angelatlarge/RGBOV/TLC5940/RGBOV.sch

## KiCad design TLC5940/RGBOV.sch (2013-05-15)

Schematic: RGBOV.sch

Parts:
C1, C2: 22pF
C3, C4: C
IC1: ATMEGA328-P; DIL28
IC2: TLC5940
R1: 2K2
X1: CRYSTAL

Notes on the sheet:
PROG indicator
Hall switch on indicator
green
white
black
yellow
red
IREFpin must be connected to GND through an IREF resistor The max channel I of TLC5940 = V-IREF/R-IREF * 31.5. V-IREF is usually 1.24V, so R-IREF=2k2 yields 17mA channel I
Parallel SIN
to BTH
Hall effect switch
