angelatlarge/RGBOV/shared/graphic.c

#ifndef GRAPHIC_C
#define GRAPHIC_C
#include <avr/pgmspace.h>

// Define useful padding for the graphics
#define PAD_001	0x00
#define PAD_002	PAD_001, PAD_001
#define PAD_003	PAD_001, PAD_001, PAD_001
#define PAD_005	PAD_003, PAD_002
#define PAD_010	PAD_005, PAD_005
#define PAD_020	PAD_010, PAD_010
#define PAD_030	PAD_020, PAD_010
#define PAD_040	PAD_020, PAD_020
#define PAD_050	PAD_040, PAD_010
#define PAD_100	PAD_050, PAD_050

/* 	Rules of graphics
	Horizontal dimension first, vertical dimension second
	First palette color MUST be black
	Palette order is (RGB)
*/	


#define TEST_GRAPHIC_F

#if defined TEST_GRAPHIC_A

// Test graphic A
#define GRAPHIC_WIDTH	100
#define GRAPHIC_HEIGHT	30
#define PALETTE_SIZE	5
//~ uint8_t palette[PALETTE_SIZE * 3] = {0x07, 0x07, 0x07, 0x00, 0x00, 0x00};
uint8_t palette[PALETTE_SIZE * 3] = {
	0x00, 0x00, 0x00, 
	0x07, 0x00, 0x00,
	0x00, 0x07, 0x00, 
	0x00, 0x00, 0x07,
	0x07, 0x00, 0x07,
};
	//~ 0x07, 0x00, 0x00
	//~ 0x00, 0x07, 0x00, 
	//~ 0x00, 0x00, 0x07};
#ifdef PROGMEM_GRAPHIC
const uint8_t graphic[GRAPHIC_WIDTH][GRAPHIC_HEIGHT] PROGMEM = 
#else // PROGMEM_GRAPHIC
uint8_t graphic[GRAPHIC_WIDTH][GRAPHIC_HEIGHT] = 
#endif 
{
//~  1,    2,    3,    4,    5,    6,    7,    8,    9,   10,   11,   12,   13,   14,   15,   16,   17,   18,   19,   20,   21,   22,   23,   24,   25,   26,   27,   28,   29,   30
	
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
{0x00,0x00,0x00,0x00,0x00,0x00,0x00,0x00,0x00,0x00,0x00,0x00,0x00,0x03,0x00},
{0x00,0x00,0x00,0x00,0x00,0x00,0x00,0x00,0x00,0x00,0x00,0x00,0x00,0x00,0x03},


};


#endif /* Which test graphic is defined */

#endif /* GRAPHIC_C */
