angelatlarge/RGBOV/TLC5940/load.cpp

#include <string.h>
#include "../shared/load.h"
#include "../shared/settings.h"
#include "strfmt.h"
#include "util/delay.h"



#if INTENSITY_LEVELS>1			
#error For TLC5940 INTENSITY_LEVELS must be set at zero
#endif


#define nop()  __asm__ __volatile__("nop")

#include "../shared/graphic.c"

#if GRAPHIC_HEIGHT>VERTICAL_PIXELS
#	define COLUMN_DATA_BYTES	(GRAPHIC_HEIGHT*3)
#else
#	define COLUMN_DATA_BYTES	(VERTICAL_PIXELS*3)
#endif

#define STR_HELPER(x) #x
#define STR(x) STR_HELPER(x)

#pragma message "#################################"
#pragma message "###   Horizontal pixels " STR(HORZ_PIXELS)      "   ###"
#pragma message "###   Vertical pixels    " STR(VERTICAL_PIXELS) "   ###"
#pragma message "###   Graphic height     " STR(GRAPHIC_HEIGHT)  "   ###"
#pragma message "###   Graphic width     " STR(GRAPHIC_WIDTH)  "   ###"
#pragma message "###   Sides               " STR(SIDES_COUNT)  "   ###"
#pragma message "###   Spokes              " STR(SPOKES_COUNT)  "   ###"
#pragma message "#################################"


#define PRECOMPUTE_PALETTE		/* 	Optimization that does palette exponentiation at initialization.  
									Can saves about 51.2us of the loading time
									*/

#define LEDS_PER_CHIP		5
#define CHIPS_PER_UNIT		3
#define LINES_PER_CHIP		(LEDS_PER_CHIP*3)

/*
	Unit = circuit (LED drivers) for one spoke, one side.
*/



	
#define TLC5940_XLAT_BIT	7
#define TLC5940_XLAT_PORT	PORTD
#define TLC5940_XLAT_DDR	DDRD
#define TLC5940_XLAT_PINS	PIND

#define TLC5940_DCPRG_BIT	4
#define TLC5940_DCPRG_PORT	PORTB
#define TLC5940_DCPRG_DDR	DDRB
#define TLC5940_DCPRG_PINS	PINB

#define TLC5940_VPRG_BIT	5
#define TLC5940_VPRG_PORT	PORTB
#define TLC5940_VPRG_DDR	DDRB
#define TLC5940_VPRG_PINS	PINB

#define DRIVER_SWITCH_PORT	PORTC
#define DRIVER_SWITCH_BIT	5
#define DRIVER_SWITCH_DDR	DDRC
#define DRIVER_SWITCH_PINS	PINC

#define PROGMEM_GRAPHIC
	
//~ static uint8_t nColumnData[SIDES_COUNT*SPOKES_COUNT][COLUMN_DATA_BYTES];
static uint8_t useHeight = (VERTICAL_PIXELS<GRAPHIC_HEIGHT) ? VERTICAL_PIXELS : GRAPHIC_HEIGHT;
#define VOLREG

static uint8_t nUnitWidth = HORZ_PIXELS / SPOKES_COUNT;

void loadingPrepareUpdate(uint8_t idxHorizontalPixel) {
	
	TLC5940_XLAT_PORT &= ~(1<<TLC5940_XLAT_BIT);		// XLAT -> low

	uint8_t idxUnit = 0;
	
	do { // This is the unit loop
		
		// Set the bits to go to the right unit
		switch (idxUnit) {
		case 1:
			//~ dputs("Port off");
			DRIVER_SWITCH_PORT &= ~(1<<DRIVER_SWITCH_BIT);
			break;
		case 0:
			//~ dputs("Port on");
			DRIVER_SWITCH_PORT |= (1<<DRIVER_SWITCH_BIT);
			break;
		}
		
		/* 	Wait for the switch to settle down
			We may not need it depending on how long the subsequent operations take
			in the worst case the current switch we are using.
			
			Some faster switches:
				SN74LVC1G3157 
				TS5A3157
				TS12A12511 - wide voltage range, up to 100ns propagation time
		*/
		nop();
		nop();
		nop();
		nop();
		nop();
		nop();
		nop();
		nop();
		nop();
		nop();
		nop();
		nop();
		nop();
		nop();
		nop();
		nop();
		nop();
		nop();
		nop();
		nop();
		nop();
		nop();
		nop();
		nop();
		nop();
		nop();
		nop();
		nop();
		
			
		// Use this for a single spoke
		//~ uint8_t nUnitColumnIndex = idxHorizontalPixel;
		// Use this for more than one spoke
		uint8_t nUnitColumnIndex = (idxHorizontalPixel + nUnitWidth*idxUnit) % HORZ_PIXELS;
		
		if (
					( nUnitColumnIndex<GRAPHIC_WIDTH ) 
				&& 
					(idxHorizontalPixel<HORZ_PIXELS) 		// Overflow generates black:
															// if the caller tells us to draw a non-existent pixel
															// we draw black
			) 
		{
			// Write graphics data to the drivers

			/* 	Padding: we need to pre-pad
				We will send 15 12-bit values (180 bits) which is 22.5 8-bit SPI 8-bit bytes
				For every TLC5490 we actually need to send 16 12-bit values (192 bits in total)
				because that's what the TLC5490 serial comms expect. 
				Since we are using only 15 of the output lines, 
				the 16th value is unnecessary (we are not using OUT15)
				We also need to pad for the extra nibble (22.5 SPI above) 
				So if we start by sending the empty 12-bit value, we are OK
				This padding needs to be done for every chip
			*/
			SPDR = 0;					// First 8 bits of the empty 12-bit data
			while(!(SPSR & (1<<SPIF))) {
				// Wait for the transfer to finish
			}
			SPDR = 0;					// Last 4 bits of the empty 12-bit data
										// plus the empty 4 high bits of the first intensity data
			uint8_t nBytesSent = 2;	// Initialize to two to account for 
										// the two blanking bytes we just sent
			VOLREG uint8_t idxNextSendType = 2;	// The next send type is type 2
												// so we indicate that
			
			// Different curColDatas are not implemented yet
			//~ uint8_t * curColData = nColumnData[idxUnit];
			
			const uint8_t * ptrGraphicFirst = &(graphic[nUnitColumnIndex][0]);
			const uint8_t * ptrGraphicLastPlusOne = ptrGraphicFirst + GRAPHIC_HEIGHT;
			const uint8_t * ptrGraphic = ptrGraphicFirst + VERTICAL_PIXELS; // Note: we'll use PRE-decrement everywhere
			
			VOLREG uint8_t idxChannel = 2;	// We want to walk the channels in reverse
			VOLREG uint8_t nPaletteIndex = 0;
			if (--ptrGraphic<ptrGraphicLastPlusOne) {
				nPaletteIndex = pgm_read_byte(ptrGraphic);
			} 
			//~ uint8_t * ptrDataSrc = palette + nPaletteIndex*3+idxChannel--;
			uint8_t * ptrDataSrc = &palette[nPaletteIndex*3+idxChannel--];
			VOLREG uint8_t dataByte = *ptrDataSrc;
			ptrDataSrc--;
			//~ VOLREG uint8_t dataByte = (idxChannel++>=1)?0xFF:0x00;
			
			VOLREG uint8_t toSPDR = dataByte;
			uint8_t nChipsSent = 0;
			
			for (;;) { // Send bytes loop
				while(!(SPSR & (1<<SPIF))) {
					// Wait for the previous transfer to finish
				}
				SPDR = toSPDR;			// Send the byte
				nBytesSent++;
				
				// Check for LED driver edge
				if (nBytesSent == 24) {
					// Send fake (zero-ed out) data for channel 16, which we do not use
					nBytesSent = 0;
					
					if (++nChipsSent == CHIPS_PER_UNIT) 
						break;
					
					while(!(SPSR & (1<<SPIF))) {
						// Wait for the previous transfer to finish
					}
					SPDR = 0;					// First 8 bits of the empty 12-bit data
					while(!(SPSR & (1<<SPIF))) {
						// Wait for the transfer to finish
					}
					SPDR = 0;					// Last 4 bits of the empty 12-bit data
												// plus the empty 4 high bits of the first intensity data
					idxNextSendType = 1;		// It will get incremented first
												// so the first byte will actually be
												// idxNextSendType = 2
					nBytesSent += 2;
					idxChannel = 2;
				}
				
				// Update the send type
				if (++idxNextSendType>2) { idxNextSendType = 0; }
				//~ ++idxNextSendType %= 4;
				
				// Prepare the next one for loading
				if (idxNextSendType==1) {
					// Case 1: Need to send the low nibble + padding
					toSPDR = dataByte<<4;
				} else {
					// Either way we need another new data in dataByte
					if (idxChannel==2) {
						// Load next palette index
						/* 	Used to have an out-of-bounds check here
							but it isn't necessary 
						if (--ptrGraphic < ptrGraphicFirst)
							break;
						*/
						if (--ptrGraphic<ptrGraphicLastPlusOne) {
							nPaletteIndex = pgm_read_byte(ptrGraphic);
							//~ ptrDataSrc = palette + nPaletteIndex*3+2;
							ptrDataSrc = &palette[nPaletteIndex*3+2];
						}
					}
					
					dataByte = *ptrDataSrc;
					ptrDataSrc--;
					//~ dataByte = (idxChannel>=1)?0xFF:0x00;
					if (idxChannel--==0) idxChannel = 2;
					//~ This fails: ++idxChannel %= 3;
					
					if (idxNextSendType) {
						// idxSendType == 2
						// Case 2: Need to send pure data
						toSPDR = dataByte;
					} else {
						// idxSendType == 0
						// Case 0: Need to send padding + high nibble
						toSPDR = dataByte >> 4;
					}
				}
				
			} // End of send bytes loop
			
		} else {
			// Send black
#ifdef BLANK_MANUALLY
			// Manual blanking by twiddling the clock bit
			SPCR &= ~(1<<SPE)		// Disable SPI
			PORTB &= ~(1<<3);			// Data line low
			for (uint16_t i=0;i<192*CHIPS_PER_UNIT;i++) {
				PORTB |= (1<<5);			// Clock high
				nop();
				PORTB &= ~(1<<5);		// Clock low
			}
#else		
			// Blank by sending zeroed out data
			for (uint8_t i=0;i<24*CHIPS_PER_UNIT;i++) {		// 24 is the number of 8-bit bytes to send
															// in order to send 16 12-bit values
				while(!(SPSR & (1<<SPIF))) {
					// Wait for the previous transfer to finish
				}
				SPDR = 0;			// Send the byte
			}		
#endif		
		}
		
	} while (++idxUnit < SIDES_COUNT*SPOKES_COUNT);	// 	End of the unit loop,
	

	
}

void loadingUpdateDisplay(uint8_t idxHorizontalPixel) {
	//~ PORTD |= 1<<3;
	//~ uint8_t tcc1bSave = TCCR1B;
	//~ TCCR2B &= ~((1<<CS22)|(1<<CS21)|(1<<CS20));
	//~ for (int i=0;i<10000;i++) nop();
	TLC5940_XLAT_PORT |= 1<<TLC5940_XLAT_BIT;			// XLAT -> high
	//~ TCNT2H = 0;
	//~ for (int i=0;i<10000;i++) nop();
	//~ TCNT2 = 0;
	//~ PORTD &= ~(1<<3);
	//~ for (int i=0;i<10000;i++) nop();
	//~ TCCR2B = tcc1bSave;
	//~ for (int i=0;i<100;i++) nop();
	nop();
	TLC5940_XLAT_PORT &= ~(1<<TLC5940_XLAT_BIT);			// XLAT -> low
}

void loadingInitDisplay() {
	
	// Greyscale timer
	// We will use OC2B as a BLANK line
	// so we set PD3 as output
	DDRD |= 1<<3;		// OC2B is PD3, we are using PWM to toggle BLANK using that pin
	TLC5940_XLAT_DDR |= 1<<TLC5940_XLAT_BIT;
	
	// TCCR2A is the blanking timer, outputs on OC2B line
	TCCR2A = 0
//		|(1<<COM2A1)|(0<<COM2A0)	// Clear OC2A on Compare Match, set OC2A at BOTTOM (non-inverting mode).
//									// Set OC2A on Compare Match, clear OC2A at BOTTOM, (inverting mode).
		|(1<<COM2B1)|(0<<COM2B0)	// Clear OC2B on Compare Match, set OC2B at BOTTOM (non-inverting mode).
									// Set OC2B on Compare Match, clear OC2B at BOTTOM, (inverting mode).
		|(1<<WGM21)|(1<<WGM20)		// Fast PWM
		;
	TCCR2B = 0
		|(0<<WGM22)							// Fast PWM
		|(0<<CS22)|(0<<CS21)|(1<<CS20)		// Prescaler = 1
		;
	OCR2A = 0x02;				/* 	If the OCR2A is set equal to BOTTOM, the output will
									be a narrow spike for each MAX+1 timer clock cycle. */
	// VPRG -> low: start with pwm mode
	TLC5940_VPRG_PORT &= ~(1<<TLC5940_VPRG_BIT);
	// DCPRG -> low
	TLC5940_DCPRG_PORT &= ~(1<<TLC5940_DCPRG_BIT);

	// Precompute the palette
#	ifdef PRECOMPUTE_PALETTE
		for (int idxPal = 0; idxPal<PALETTE_SIZE; idxPal++) {
			for (int idxColor = 0; idxColor<3; idxColor++) {
				palette[idxPal*3+idxColor] = (1<<palette[idxPal*3+idxColor]) - 1;
			}
		}
#	else /* PRECOMPUTE_PALETTE */
		// Nothing to do 
#	endif /* PRECOMPUTE_PALETTE */

	// Set the driver switcher to be output
	ADCSRA = 0;	// ADC off
	DRIVER_SWITCH_DDR |= 1<<DRIVER_SWITCH_BIT;
		
	// Set SPI pins to output
	DDRB = 0xFF;
		
	// Set up SPI
	SPCR = 0
		|(0<<SPIE)			// Interrupt enable
		|(1<<SPE)			// Bit 6 – SPE: SPI Enable
		|(0<<DORD)			// Bit 5 – DORD: Data Order
							// When the DORD bit is written to zero, the MSB of the data word is transmitted first
		|(1<<MSTR)			// Bit 4 – MSTR: Master/Slave Select
							// This bit selects Master SPI mode when written to one
		|(0<<CPOL)			// Bit 3 – CPOL: Clock Polarity
							// When CPOL is written to zero, SCK is low when idle.
		|(0<<CPHA)			// Bit 2 – CPHA: Clock Phase
		|(0<<SPR1)|(0<<SPR0)// Clock: Fosc/4 [ SPR1=0, SPR0:0 ]
		//~ |(1<<SPR1)|(1<<SPR0)// Clock: Focs/128
		//~ |(1<<SPR1)|(0<<SPR0)// Clock: Focs/64
		;
	SPSR = 0
		//~ |(0<<SPI2X)			// Bit 0 – SPI2X: Double SPI Speed Bit
		|(1<<SPI2X)			// Bit 0 – SPI2X: Double SPI Speed Bit
		;
}
