angelatlarge/RGBOV/shared/settings.h

#define	HORZ_PIXELS				45
//~ #define	HORZ_PIXELS				1
#define	INTENSITY_LEVELS		1
#define	INTENSITY_COUNTER_MAX	1<<(INTENSITY_LEVELS-1)
#define VERTICAL_PIXELS			15
//~ #define VERTICAL_PIXELS			10
#define SIDES_COUNT				1
#define SPOKES_COUNT			2
//~ #define VERTICAL_PIXELS			10


#define PROGMEM_GRAPHIC
#undef DRAW_INIT_HELLO
#undef DRAW_WHEEL_SPEED
