angelatlarge/RGBOV/(commit log)

2013-01-23 Working on RGBOV schematic
    [RGBOV.sch]
2013-01-28 Fast bitbanging. Giving up on the SPI way of sending data.
    [RGBOV.sch]
2013-01-28 Directory cleanup
    [RGBOV.sch, calc.xls]
2013-01-31 Added the no PWM option Writing in white now. Updated the schematic to show a hall effect switch
    [RGBOV.sch]
2013-01-31 Added a comment about continuosely updating the wheel speed.
2013-02-01 Added comments on using a bootloader
    [calc.xls]
2013-02-02 Bootloading works: changed the CPU speed to 20Mhz because I forgot to check the fuse settings before burning the fuses for the bootloader.
2013-02-02 Added code for variable prescaler, which is necessary for 20Mhz speeds
    [calc.xls]
2013-02-04 Added notes on current and cost
2013-02-14 Reorganized directories to have two implementations
    [RGBOV.sch]
2013-02-15 First test of the TLC5940
    [RGBOV.sch]
2013-02-16 Fixed a couple of flashing led bugs.
2013-02-16 Continuing to fix up the splitting of the project
    [RGBOV.sch]
2013-02-20 Split the dataloading into pre-loading and flipping the switch on.
    [RGBOV.cpp, load.cpp, load.h]
2013-02-20 Testing the full 120 pixel load. All speed optimizations turned on
    [calc.xls]
2013-03-24 Cleaning up the timing calculations
    [calc.xls]
2013-03-24 Revert "Almost completely unrolled version of TLC5940 load"
    This reverts commit df092ecc6e176989cb39031d3abdd6f8b06828e9.
    [load.cpp]
2013-04-06 First version of serial SPI loading code
2013-04-07 First version of SPI serial loading that works.
2013-04-08 Cleaning up the load code. Fixed alignment issues
    [load.cpp]
2013-04-15 In a single-unit environment the graphic data is now loaded correctly (finally!)
    [graphic.c, load.cpp, settings.h]
2013-04-21 Fixed two multi-unit bugs
    [load.cpp]
2013-04-21 Change SPI speed to maximum
2013-04-22 Should be fast (but isn't quite) version where the chips are unrolled. Has a bug in that dirvers beyond the first are not loaded correctly
    [load.cpp]
2013-05-15 Final changes on the serial SPI branch
    [RGBOV.sch, calc.xls]
2013-05-19 * Added nop() for switch switching purposes
2013-05-19 * Commented out the test display * Fixed again (corretly now?) the prescaler setting bug
    [RGBOV.cpp]
2013-05-27 Fixed the problem with prescaler computation at low speeds
    [RGBOV.cpp]
2013-06-03 RGBOV.cpp: comment change load.cpp: comment changes, improved handling of going outside the graphic, longer wait for the analog switch
2013-07-02 Fixed the one-off timer problem that caused a dead spot in the image
    [RGBOV.cpp]
